brandinzhang/Multifunctional_Car_Navigation_and_Control_Algorithm_Implemented_in_cpp/README.md

# CAU 2025 Intelligent Systems Summer Project: Multi-functional Car Navigation and Control Algorithm Based on C++  
# cau2025智能系暑期大作业：只使用电容电阻二极管！--基于C++实现的多功能寻迹车导航与控制算法











## Demo Videos / 演示视频
### 1. Main Function Demonstration / 主要功能演示

https://github.com/user-attachments/assets/f8b0f884-4c11-482b-9c53-d50436c44105

### 2. System Testing / 系统测试

https://github.com/user-attachments/assets/ff308263-f283-48aa-81d9-5dbc589d4fc7

## Project Overview / 项目概述
- This project implements intelligent car navigation algorithms using C/C++ hybrid programming with strict hardware constraints:  
  **Core Requirement**: Only basic electronic components (capacitors, resistors, transistors, etc.) were permitted - pre-made modules were prohibited.  

  All hardware designs and algorithm implementations are detailed in [main.pdf](main.pdf).  

本项目基于严格的硬件限制开发智能汽车导航算法：  
**核心要求**：仅允许使用基础电子元件（电容/电阻/三极管等），禁止使用现成模块  

完整硬件设计与算法实现详见[main.pdf](main.pdf)

## Development Details / 开发详情
- **Code**: Written independently by me  
  **代码**：由本人独立编写
- **Circuit**: Co-designed and soldered with teammates  
  **电路**：与队友共同完成设计与焊接
- **Environment**: Keil MDK as primary IDE, materials list complied in Excel as required  
  **开发环境**：以Keil MDK为主开发环境，材料清单已按要求整理至Excel文件
- **Achievement**: Earned highest honors grade A+  
  **成果**：最终获得最高荣誉等级A+

# Hardware Specifications / 硬件详情
## Main Control Circuit / 主控制电路  
Main Control Circuit  

## Vehicle Structure / 整车结构  
Full Structure
