brandinzhang/Multifunctional_Car_Navigation_and_Control_Algorithm_Implemented_in_cpp/清单.xls

电子技术课程设计元器件清单
班级： |  | 组别： |  | 成员：
类型 | 型号 | 规格/类型 | 领取数量 | 归还数量 | 备注
核心 部件 | 小车底盘 | 含车轮、减速直流电机、测速码盘等 | 1
 | STM32 开发板 | 含ST-LINK仿真器、Type-C下载线
 | Arduino 开发板 | Arduino UNO R3开发板套件
电阻 | 1 | ±5％，1W
 | 10 | ±5％，1/4W
 | 100 | ±5％，1/4W
 | 200 | ±5％，1/4W
 | 470 | ±5％，1/4W
 | 510 | ±5％，1/4W
 | 1K | ±5％，1/4W
 | 2K | ±5％，1/4W
 | 5.1K | ±5％，1/4W
 | 6.8K | ±5％，1/4W
 | 8.2K | ±5％，1/4W
 | 10K | ±5％，1/4W | 0
 | 20K | ±5％，1/4W
 | 30K | ±5％，1/4W
 | 47K | ±5％，1/4W
 | 51K | ±5％，1/4W
 | 100K | ±5％，1/4W
 | 200K | ±5％，1/4W
 | 510K | ±5％，1/4W
 | 1M | ±5％，1/4W
 | 2M | ±5％，1/4W
电容 | 330pF | 陶瓷，直插
 | 2.2nF | 陶瓷，直插
 | 0.01uF | 陶瓷，直插
 | 0.033uF | 陶瓷，直插
 | 0.1uF | 陶瓷，直插
 | 1uF | 陶瓷，直插
 | 10uF | 陶瓷，直插
 | 47uF | 陶瓷，直插
 | 100uF | 陶瓷，直插
 | 470uF | 陶瓷，直插
电位器 | 100 | 多圈精密，3296W
 | 10K | 多圈精密，3296W
 | 100K | 多圈精密，3296W
芯片 | CD4001 | 双列直插 |  |  | 必须焊插座
 | CD4011 | 双列直插 |  |  | 必须焊插座
 | CD4071 | 双列直插 |  |  | 必须焊插座
 | CD4081 | 双列直插 |  |  | 必须焊插座
 | CD4069 | 双列直插 | 2 |  | 必须焊插座
 | CD4013 | 双列直插 |  |  | 必须焊插座
 | CD4027 | 双列直插 |  |  | 必须焊插座
 | CD4511 | 双列直插 | 2 |  | 必须焊插座
 | CD4518 | 双列直插 | 1 |  | 必须焊插座
 | CD40192 | 双列直插 |  |  | 必须焊插座
 | CD40193 | 双列直插 |  |  | 必须焊插座
 | 74LS90 | 双列直插 |  |  | 必须焊插座
 | 74LS78 | 双列直插 |  |  | 必须焊插座
 | 74LS138 | 双列直插 |  |  | 必须焊插座
 | ADC0832 | 双列直插 |  |  | 必须焊插座
 | ICL7135 | 双列直插 |  |  | 必须焊插座
 | NE555 | 双列直插 |  |  | 必须焊插座
 | LM324 | 双列直插 |  |  | 必须焊插座
 | LM339 | 双列直插 |  |  | 必须焊插座
 | LM358 | 双列直插 |  |  | 必须焊插座
 | LM393 | 双列直插 | 6 |  | 必须焊插座
 | 18B20 | 直插TO-92
 | LM35DZ | 直插TO-92
 | LM7805 | 直插TO-220 | 5
 | LM1117-3.3 | 直插TO-220 | 2
 | ULN2003 | 双列直插 |  |  | 必须焊插座
 | L9110H | 双列直插 | 2 |  | 必须焊插座
 | L298N | 直插Multiwatt15 | 2
晶体管 | TIP122 | 直插TO-220 | 0
 | TIP127 | 直插TO-220
 | 2N9012 | 直插TO-92
 | 2N9013 | 直插TO-92
 | 1N4148 | 直插
 | 1N4001 | 直插
传感器 | 超声波传感器（对） | TCT40-16T发 / CT40-16R收 | 1
 | 槽型光耦ITR9606 |  | 2
 | 红外传感TCRT5000 |  | 6
 | 光敏电阻5506 / 5516 |  |  |  | 改为5516
 | 热敏电阻10D-7
 | 湿敏电阻CJ-HR31D
 | 拾音麦克风（咪头） | 电容式，56dB，6*5mm | 2
 | 烟雾传感器MQ2
 | 霍尔器件49E |  | 2
其他 | PCB实验板（洞洞板） | 5连孔，单面100*150mm | 1
 | 18650电池 | 锂电池3.7/4.2V | 2
 | 40KHz无源晶振
 | 8MHz无源晶振
 | 自锁按键 | 7*7mm
 | 轻触按键 | 6*6mm
 | 发光二极管 | 红、绿、黄、白 | 红，2
 | 共阴极七段数码管 |  | 3 |  | 必须焊插座
 | 蜂鸣器 | 电磁式，无源 | 2
 | 超声波固定架
插座 | 6DIP插座 | 双列直插 |  |  | 公用消耗品
 | 8DIP插座 | 双列直插 | 6 |  | 公用消耗品
 | 14DIP插座 | 双列直插 |  |  | 公用消耗品
 | 16DIP插座 | 双列直插 | 3 |  | 公用消耗品
 | 20DIP插座 | 双列直插 | 1 |  | 公用消耗品
 | 24DIP插座 | 双列直插 |  |  | 公用消耗品
 | 28DIP插座 | 双列直插 |  |  | 公用消耗品
 | 40DIP插座 | 双列直插 |  |  | 公用消耗品
接插件 | 40P杜邦公对母 | 20cm
 | 40P杜邦母对母 | 10cm
 | 40P杜邦母对母 | 20cm
 | 40P单排针
 | 2*6P双排针
 | 跳线帽
五金 | 圆头螺丝 | PM3*6
 | 螺母 | M3
 | 自攻螺丝 | PA2.3*8
 | 单头铜柱 / 尼龙柱 | M3*25
 | 双通铜柱 | M3*20
 | 双通铜柱 | M3*30 | 6
仪器工具 | 数字万用表 |  | 1
 | 示波器 |  | 1 |  | 两个组一台
 | 稳压电源
 | 锂电池充电器 |  | 1 |  | 每个实验室3个
 | 面包板
 | 剥线钳 |  | 1
 | 偏口钳
 | 一字螺丝刀 |  | 1
 | 十字螺丝刀 |  | 1
 | 镊子 |  | 1
 | 电烙铁+烙铁架 |  | 1 |  | 含清洁海绵
消耗品 | 导线 | 红、黑、黄、蓝、白 |  |  | 公用消耗品
 | 焊锡 | 0.5mm |  |  | 公用消耗品
 | 烙铁头 |  |  |  | 公用消耗品
 | 绝缘胶布 |  |  |  | 公用消耗品
 | 9V电池 |  |  |  | 公用消耗品
