brandinzhang/Multifunctional_Car_Navigation_and_Control_Algorithm_Implemented_in_cpp/Hardware/Servo.c

#include "stm32f10x.h"                  // Device header
#include "PWMServo.h"

void Servo_Init(void)
{
	PWM_Init2();
}

void Servo_SetAngle(float Angle)
{
	PWM_2SetCompare3(Angle / 180 * 2000 + 500);
}
