brandinzhang/Multifunctional_Car_Navigation_and_Control_Algorithm_Implemented_in_cpp/Hardware/OLED_Font.h

#ifndef __OLED_FONT_H
#define __OLED_FONT_H
const uint8_t OLED_chinese[][16]=
	//注意第二行和第三行要调转一下位置
//	请输入验证码
{ 	0x20,0x22,0xEC,0x00,0x20,0x22,0xAA,0xAA,//0
	0x00,0x00,0x7F,0x20,0x10,0x00,0xFF,0x0A,
      0xAA,0xBF,0xAA,0xAA,0xEB,0xA2,0x20,0x00,
      0x0A,0x0A,0x4A,0x8A,0x7F,0x00,0x00,0x00,

 0x88,0x68,0x1F,0xC8,0x0C,0x28,0x90,0xA8,
	      0x09,0x09,0x05,0xFF,0x05,0x00,0xFF,0x0A,//2
      0xA6,0xA1,0x26,0x28,0x10,0xB0,0x10,0x00,
      0x8A,0xFF,0x00,0x1F,0x80,0xFF,0x00,0x00,

 0x00,0x00,0x00,0x00,0x00,0x01,0xE2,0x1C,
	      0x80,0x40,0x20,0x10,0x0C,0x03,0x00,0x00,//4
      0xE0,0x00,0x00,0x00,0x00,0x00,0x00,0x00,
      0x00,0x03,0x0C,0x30,0x40,0xC0,0x40,0x00,
	
 0x02,0xFA,0x02,0x02,0xFF,0x42,0x20,0x50,//6
	      0x10,0x31,0x11,0x49,0x89,0x7F,0x42,0x5C,
      0x4C,0x43,0x4C,0x50,0x20,0x60,0x20,0x00,
      0x40,0x4F,0x60,0x58,0x47,0x60,0x40,0x00,

 0x20,0x20,0x21,0xE6,0x00,0x02,0x02,0xC2,//8
	      0x00,0x00,0x00,0x7F,0x20,0x50,0x40,0x7F,
      0x02,0x02,0xFE,0x82,0x82,0xC3,0x82,0x00,

      0x40,0x40,0x7F,0x40,0x40,0x60,0x40,0x00,

0x02,0x82,0xF2,0x4E,0x43,0xE2,0x42,0xFA,//10
      0x01,0x00,0x7F,0x20,0x20,0x7F,0x08,0x09,
      0x02,0x02,0x02,0xFF,0x02,0x80,0x00,0x00,

      0x09,0x09,0x0D,0x49,0x81,0x7F,0x01,0x00,

0x00,0x00,0x00,0x00,0x80,0xC0,0xC0,0x80,//12
 0x00,0x00,0x00,0x00,0x31,0x7B,0x7B,0x31,
      0x00,0x00,0x00,0x00,0x00,0x00,0x00,0x00,
      0x00,0x00,0x00,0x00,0x00,0x00,0x00,0x00,
	//已取件，关闭快递盒
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
	
	0x00,0x00,0x00,0x00,0xFF,0x00,0x00,0x00,
	0x00,0x00,0x00,0x00,0xFF,0x00,0x00,0x00,//| 92
	
	0x00,0x02,0x02,0x7C,0x80,0x00,0x00,0x00,
	0x00,0x40,0x40,0x3F,0x00,0x00,0x00,0x00,//} 93
	
	0x00,0x06,0x01,0x01,0x02,0x02,0x04,0x04,
	0x00,0x00,0x00,0x00,0x00,0x00,0x00,0x00,//~ 94
};

#endif
