brandinzhang/Multifunctional_Car_Navigation_and_Control_Algorithm_Implemented_in_cpp/User/hall_speed.c

#include "hall_speed.h"

#define WHEEL_DIAMETER_M   0.065f

volatile uint16_t pulse_count = 0;
volatile uint16_t speed_rpm = 0;

void HallSpeed_Init(void)
{
    RCC_APB2PeriphClockCmd(RCC_APB2Periph_GPIOA | RCC_APB2Periph_AFIO, ENABLE);
    RCC_APB1PeriphClockCmd(RCC_APB1Periph_TIM2, ENABLE);

    GPIO_InitTypeDef GPIO_InitStructure;
    GPIO_InitStructure.GPIO_Pin = GPIO_Pin_0;
    GPIO_InitStructure.GPIO_Mode = GPIO_Mode_IPU;
    GPIO_Init(GPIOA, &GPIO_InitStructure);

    GPIO_EXTILineConfig(GPIO_PortSourceGPIOA, GPIO_PinSource0);

    EXTI_InitTypeDef EXTI_InitStructure;
    EXTI_InitStructure.EXTI_Line = EXTI_Line0;
    EXTI_InitStructure.EXTI_Mode = EXTI_Mode_Interrupt;
    EXTI_InitStructure.EXTI_Trigger = EXTI_Trigger_Falling;
    EXTI_InitStructure.EXTI_LineCmd = ENABLE;
    EXTI_Init(&EXTI_InitStructure);

    NVIC_InitTypeDef NVIC_InitStructure;
    NVIC_InitStructure.NVIC_IRQChannel = EXTI0_IRQn;
    NVIC_InitStructure.NVIC_IRQChannelPreemptionPriority = 0;
    NVIC_InitStructure.NVIC_IRQChannelSubPriority = 0;
    NVIC_InitStructure.NVIC_IRQChannelCmd = ENABLE;
    NVIC_Init(&NVIC_InitStructure);

    TIM_TimeBaseInitTypeDef TIM_TimeBaseStructure;
    TIM_TimeBaseStructure.TIM_Prescaler = 7200 - 1;
    TIM_TimeBaseStructure.TIM_Period = 10000 - 1;
    TIM_TimeBaseStructure.TIM_ClockDivision = TIM_CKD_DIV1;
    TIM_TimeBaseStructure.TIM_CounterMode = TIM_CounterMode_Up;
    TIM_TimeBaseInit(TIM2, &TIM_TimeBaseStructure);

    TIM_ITConfig(TIM2, TIM_IT_Update, ENABLE);
    NVIC_EnableIRQ(TIM2_IRQn);
    TIM_Cmd(TIM2, ENABLE);
}

uint16_t HallSpeed_GetRPM(void)
{
    return speed_rpm;
}

float HallSpeed_GetSpeed(void)
{
    float circumference = 3.1416f * WHEEL_DIAMETER_M;
    return (circumference * speed_rpm) / 60.0f;
}

void EXTI0_IRQHandler(void)
{
    if (EXTI_GetITStatus(EXTI_Line0) != RESET)
    {
        pulse_count++;
        EXTI_ClearITPendingBit(EXTI_Line0);
    }
} 

void TIM2_IRQHandler(void)
{
    if (TIM_GetITStatus(TIM2, TIM_IT_Update) != RESET)
    {
        speed_rpm = pulse_count * 60;
        pulse_count = 0;
        TIM_ClearITPendingBit(TIM2, TIM_IT_Update);
    }
}
