brandinzhang/Multifunctional_Car_Navigation_and_Control_Algorithm_Implemented_in_cpp/Hardware/Irtracking.c

#include "stm32f10x.h"                  // Device header

void Irtracking_Init(void)
{
	RCC_APB2PeriphClockCmd(RCC_APB2Periph_GPIOB,ENABLE);
	
	GPIO_InitTypeDef GPIO_InitStructure;
	GPIO_InitStructure.GPIO_Mode = GPIO_Mode_IPU;
	GPIO_InitStructure.GPIO_Pin = GPIO_Pin_12 | GPIO_Pin_13;
	GPIO_InitStructure.GPIO_Speed = GPIO_Speed_50MHz;
	GPIO_Init(GPIOB,&GPIO_InitStructure);
}


uint8_t Left_Irtracking_Get(void)
{
	return GPIO_ReadInputDataBit(GPIOB,GPIO_Pin_13);
}

uint8_t Right_Irtracking_Get(void)
{
	return GPIO_ReadInputDataBit(GPIOB,GPIO_Pin_12);
}
