brandinzhang/Multifunctional_Car_Navigation_and_Control_Algorithm_Implemented_in_cpp/Hardware/Serial.c

#include "stm32f10x.h"
#include <stdio.h>
#include <stdarg.h>

void Serial_Init(void)
{
    // 使能GPIOB和USART3时钟
    RCC_APB2PeriphClockCmd(RCC_APB2Periph_GPIOB, ENABLE);
    RCC_APB1PeriphClockCmd(RCC_APB1Periph_USART3, ENABLE);

    // 配置PB10为复用推挽输出（TX）
    GPIO_InitTypeDef GPIO_InitStructure;
    GPIO_InitStructure.GPIO_Mode = GPIO_Mode_AF_PP;
    GPIO_InitStructure.GPIO_Pin = GPIO_Pin_10; // TX
    GPIO_InitStructure.GPIO_Speed = GPIO_Speed_50MHz;
    GPIO_Init(GPIOB, &GPIO_InitStructure);

    // 配置PB11为上拉输入（RX）
    GPIO_InitStructure.GPIO_Mode = GPIO_Mode_IPU;
    GPIO_InitStructure.GPIO_Pin = GPIO_Pin_11; // RX
    GPIO_InitStructure.GPIO_Speed = GPIO_Speed_50MHz;
    GPIO_Init(GPIOB, &GPIO_InitStructure);

    // 配置USART3参数
    USART_InitTypeDef USART_InitStructure;
    USART_InitStructure.USART_BaudRate = 9600;
    USART_InitStructure.USART_HardwareFlowControl = USART_HardwareFlowControl_None;
    USART_InitStructure.USART_Mode = USART_Mode_Tx | USART_Mode_Rx;
    USART_InitStructure.USART_Parity = USART_Parity_No;
    USART_InitStructure.USART_StopBits = USART_StopBits_1;
    USART_InitStructure.USART_WordLength = USART_WordLength_8b;
    USART_Init(USART3, &USART_InitStructure);

    // 使能USART3接收中断
    USART_ITConfig(USART3, USART_IT_RXNE, ENABLE);

    NVIC_PriorityGroupConfig(NVIC_PriorityGroup_2);

    NVIC_InitTypeDef NVIC_InitStructure;
    NVIC_InitStructure.NVIC_IRQChannel = USART3_IRQn;
    NVIC_InitStructure.NVIC_IRQChannelCmd = ENABLE;
    NVIC_InitStructure.NVIC_IRQChannelPreemptionPriority = 1;
    NVIC_InitStructure.NVIC_IRQChannelSubPriority = 1;
    NVIC_Init(&NVIC_InitStructure);

    USART_Cmd(USART3, ENABLE);
}

void Serial_SendByte(uint8_t Byte)
{
    USART_SendData(USART3, Byte);
    while (USART_GetFlagStatus(USART3, USART_FLAG_TXE) == RESET);
}

void Serial_SendArray(uint8_t *Array, uint16_t Length)
{
    uint16_t i;
    for (i = 0; i < Length; i ++)
    {
        Serial_SendByte(Array[i]);
    }
}

void Serial_SendString(char *String)
{
    uint8_t i;
    for (i = 0; String[i] != '\0'; i ++)
    {
        Serial_SendByte(String[i]);
    }
}

uint32_t Serial_Pow(uint32_t X, uint32_t Y)
{
    uint32_t Result = 1;
    while (Y --)
    {
        Result *= X;
    }
    return Result;
}

void Serial_SendNumber(uint32_t Number, uint8_t Length)
{
    uint8_t i;
    for (i = 0; i < Length; i ++)
    {
        Serial_SendByte(Number / Serial_Pow(10, Length - i - 1) % 10 + '0');
    }
}

int fputc(int ch, FILE *f)
{
    Serial_SendByte(ch);
    return ch;
}

void Serial_Printf(char *format, ...)
{
    char String[100];
    va_list arg;
    va_start(arg, format);
    vsprintf(String, format, arg);
    va_end(arg);
    Serial_SendString(String);
}
