brandinzhang/Multifunctional_Car_Navigation_and_Control_Algorithm_Implemented_in_cpp/Hardware/Ultrasound.c

#include "stm32f10x.h"                  // Device header
#include "Delay.h"

uint16_t Cnt;
uint16_t OverCnt;
void Ultrasound_Init(){
		
	RCC_APB1PeriphClockCmd(RCC_APB1Periph_TIM4, ENABLE);
	RCC_APB2PeriphClockCmd(RCC_APB2Periph_GPIOB, ENABLE);
	
	GPIO_InitTypeDef GPIO_InitStructure;
	GPIO_InitStructure.GPIO_Mode = GPIO_Mode_Out_PP;//trig
	GPIO_InitStructure.GPIO_Pin = GPIO_Pin_12;
	GPIO_InitStructure.GPIO_Speed = GPIO_Speed_50MHz;
	GPIO_Init(GPIOB, &GPIO_InitStructure);
	
	GPIO_InitStructure.GPIO_Mode = GPIO_Mode_IPD;//echo
	GPIO_InitStructure.GPIO_Pin = GPIO_Pin_13;
	GPIO_InitStructure.GPIO_Speed = GPIO_Speed_50MHz;
	GPIO_Init(GPIOB, &GPIO_InitStructure);
	
	TIM_InternalClockConfig(TIM4);
	TIM_TimeBaseInitTypeDef TIM_TimeBaseInitStructure;
	TIM_TimeBaseInitStructure.TIM_ClockDivision = TIM_CKD_DIV1;
	TIM_TimeBaseInitStructure.TIM_CounterMode = TIM_CounterMode_Up;
	TIM_TimeBaseInitStructure.TIM_Period = 60000 - 1;		//ARR
	TIM_TimeBaseInitStructure.TIM_Prescaler = 72 - 1;		//PSC
	TIM_TimeBaseInitStructure.TIM_RepetitionCounter = 0;
	TIM_TimeBaseInit(TIM4, &TIM_TimeBaseInitStructure);

}
float Test_Distance(){
	GPIO_SetBits(GPIOB,GPIO_Pin_12);
	Delay_us(20);
	GPIO_ResetBits(GPIOB,GPIO_Pin_12);
	while(GPIO_ReadInputDataBit(GPIOB,GPIO_Pin_13)==RESET){
	};
	TIM_Cmd(TIM4, ENABLE);
	while(GPIO_ReadInputDataBit(GPIOB,GPIO_Pin_13)==SET){
	};
	TIM_Cmd(TIM4, DISABLE);
	Cnt=TIM_GetCounter(TIM4);
	float distance=(Cnt*1.0/10*0.34)/2;
	TIM4->CNT=0;
	Delay_ms(100);
	return distance;
}
